beambuilder/dt670-arduino-readout/data/noise_compare.png

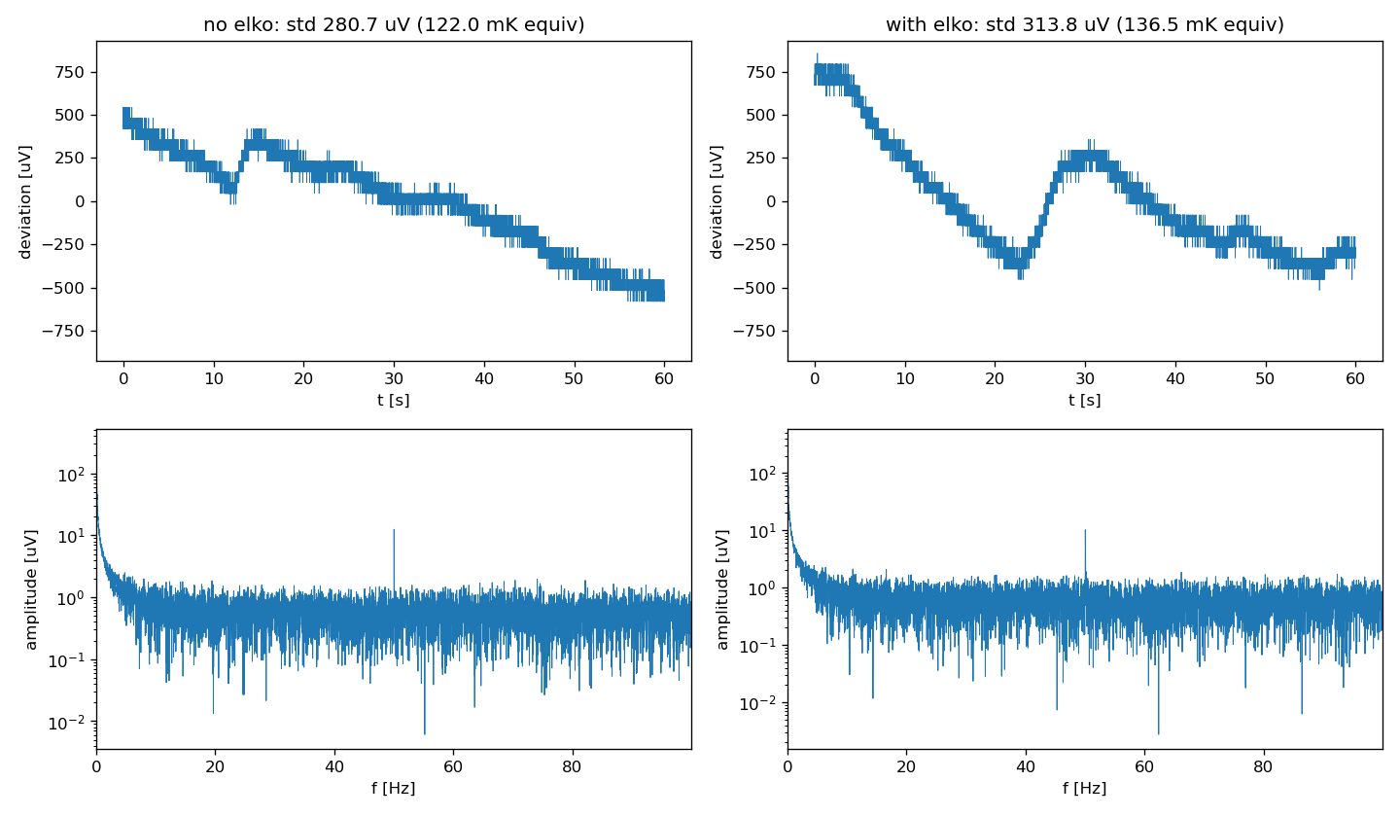
data/noise_compare.png
