beambuilder/dt670-arduino-readout/(commit log)

2026-07-31 Initial commit: DT-670 Arduino temperature readout
    LM334 10 uA current source + ADS1115 frontend, Uno R3 + W5500
    serving HTTP/JSON, Python live plot, project knowledge base in
    memory/, plus noisecap sketch and analysis scripts for the 10 uF
    rail-decoupling A/B noise comparison.
    [adsdiag.ino, adstest.ino, dt670srv.ino, liveplot.py, noisecap.ino, noisecap.py, noisecompare.py, pingtest.ino]
2026-07-31 Elko A/B noise test: decoupling placed, no bench noise change
    60 s raw ADS1115 captures at 200 Hz before/after adding 10 uF +
    100 nF rail decoupling at the LM334. Fast noise unchanged
    (36.6 vs 37.0 uV std after detrend, ~16 mK equiv); 50 Hz pickup
    12.5 -> 10.2 uV. Raw std dominated by slow thermal drift of the
    1N4004 dummy, not supply noise. Caps kept for supply robustness.
    KB updated, dt670srv reflashed.
    [noise_no_elko.csv, noise_with_elko.csv]
2026-07-31 Checkpoint: seat-current verified 10.5 uA, cleared for DT-670 install
    Measured 10.5 uA with DMM in uA mode across the empty diode seat
    (F+ -> GND) - valid because the LM334 is a true current source.
    Within the 9.4-10.9 uA trim window; no re-trim needed.
